MeArm/V1_PCBs/README.md

# V1_PCBs
Here we have the PCBs for the original controllers for the version 1 MeArm, including sliders and joysticks
