MeArm/V1_PCBs/MeBrain/MeBrain Spec.odt

MeBrain Specification

This is a work in progress and all comments (well most) would be appreciated.

Based on Arduino Leonardo which is an ATMega32u4 Breakout Board. Schematic and Eagle Board Files are in design folder

Must provide 6V high current power and pwm control for 4 hobby servos. Our basic servos can draw up to 1A each, the metal gear versions we plan to provide as an upgrade can draw more. It would be good to test these and work to them as a requirement. If higher current could be provided via the board it should to make the product easy to use with as many 4 servo systems as possible. I2C module is available to cover power and control and should be investigated. (Schematic and Eagle Board Files are in design folder)

Should have connectivity (whether pins or footprints for):

Wireless XBEE style module
Bluetooth LE module
LCD Screen

Controls to be placed on daughter boards. Currently we use 4 analogue outputs, would like to explore I2C as a possibility. There are two daughter boards designs, one for joystick style potentimeters and another for slider type.

Open source – Altium files to be released, also if we can convert to Eagle that would be good.

Low-cost

Surface mount – the unit will be pre-built

4 x servo 3 pin sockets

Servos controlled on D6,D9,D10,D11 (all PWM)

Servo outputs need to cope with current. The power wires need to be thick. The

control wires don’t need to change.

Analogue inputs on A0,A1,A2,A3

Programmed with external programmer (FTDI unit 6 x 1) – Supplied separately.

ISP 3 x2 programming header.

LEDs to show status. LEDs on pins D12 and D13. An additional one for playing with on another PWM pin

Connectors on I/O pins for hacking

ON/OFF switch.

Shape – to fit base plate on MeArm
