MeArm/V1_PCBs/MeBrain/PiBrains/TwoSnap/BrainsandJoy-F_Cu.dxf

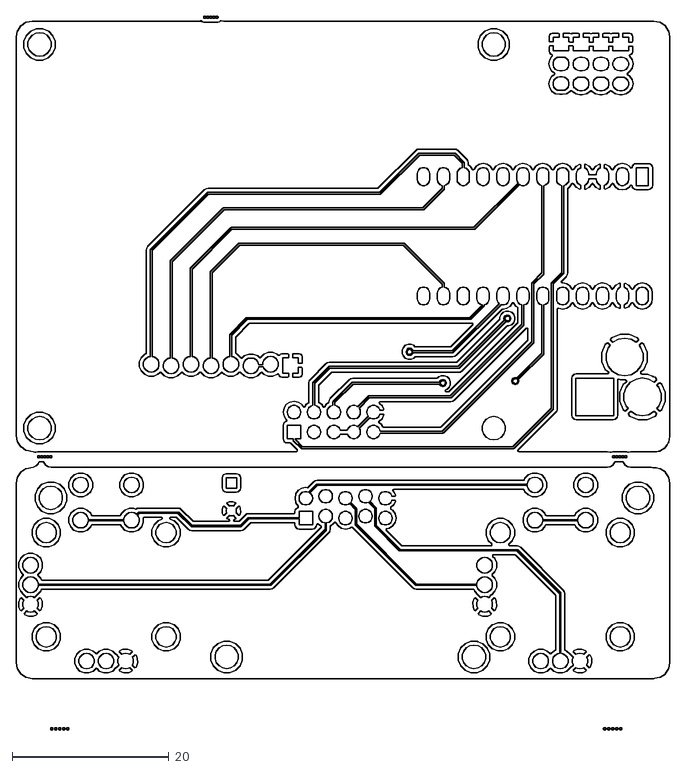
[picture p1: CAD file, 2023-10-12]
MeBrain/PiBrains/TwoSnap/BrainsandJoy-F_Cu.dxf
83.5 x 91.2
