MeArm/V1_PCBs/MeBrain/PiBrains/TwoSnap/BrainsandJoy-Edge_Cuts.dxf

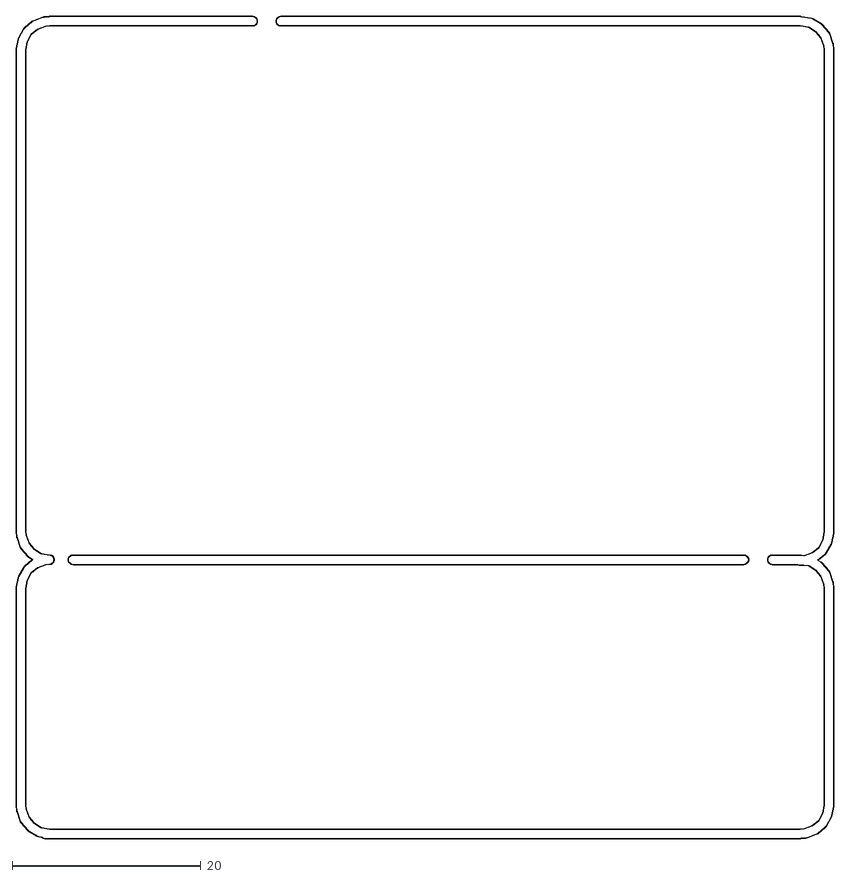
[picture p2: CAD file, 2023-10-12]
MeBrain/PiBrains/TwoSnap/BrainsandJoy-Edge_Cuts.dxf
86.5 x 87.0
