MeArm/V1_PCBs/(list of files, cad)

Other CAD files:
MeBrain/PiBrains/TwoSnap/BrainsandJoy.dxf
MeBrain/PiBrains/TwoSnap/BrainsandJoy-F_SilkS.dxf
MeBrain/PiBrains/TwoSnap/BrainsandJoy.dwg
