MeArm/V1_PCBs/slide/slide.kicad_pcb

## KiCad design slide/slide.kicad_pcb (2023-10-12)

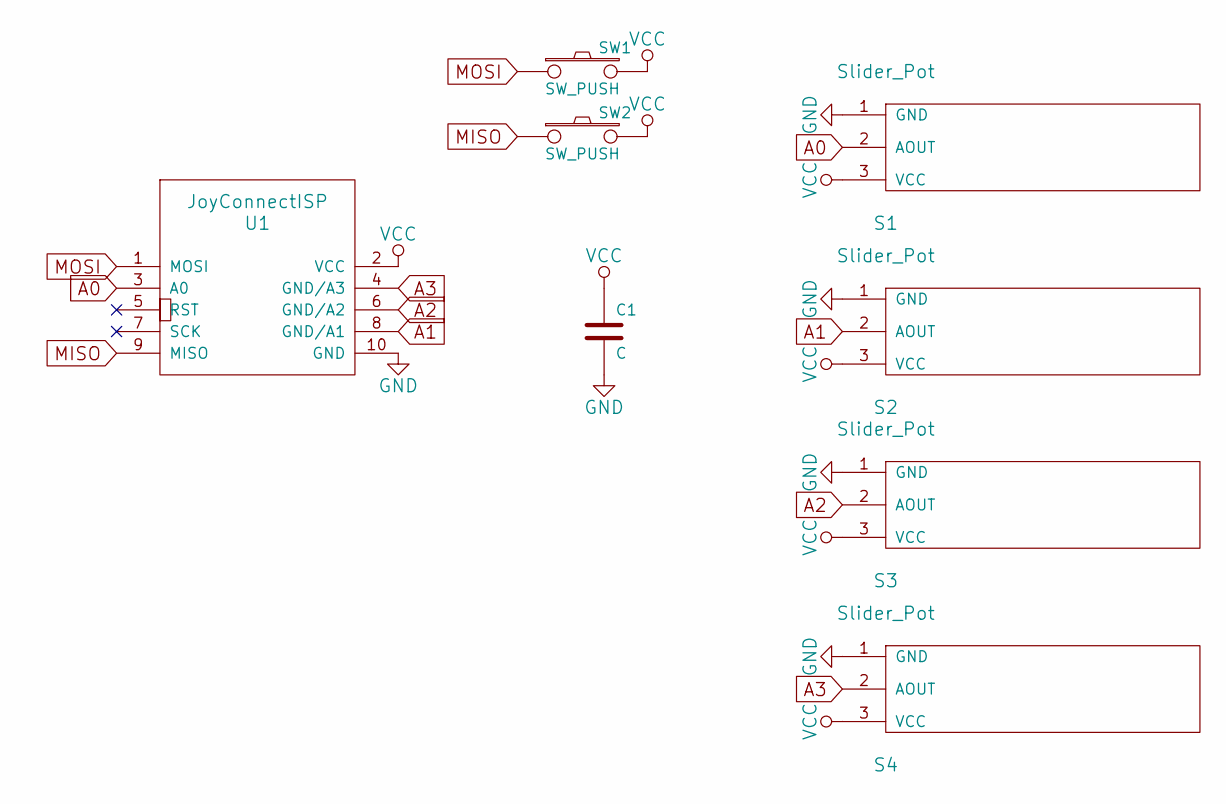
[picture p3: schematic slide.sch]

Parts:
C1: C; C_Disc_D3_P2.5
S1, S2, S3, S4: Slider_Pot; Slider_Potentiometer
SW1, SW2: SW_PUSH; TacSwitch
U1: JoyConnectISP; Pin_Header_Straight_2x05

Connections:
A0: S1.2 (AOUT), U1.3 (A0)
A1: S2.2 (AOUT), U1.8 (GND/A1)
A2: S3.2 (AOUT), U1.6 (GND/A2)
A3: S4.2 (AOUT), U1.4 (GND/A3)
GND: C1.2, S1.1 (GND), S2.1 (GND), S3.1 (GND), S4.1 (GND), U1.10 (GND)
MISO: SW2.1, U1.9 (MISO)
MOSI: SW1.1, U1.1 (MOSI)
VCC: C1.1, S1.3 (VCC), S2.3 (VCC), S3.3 (VCC), S4.3 (VCC), SW1.2, SW2.2, U1.2 (VCC)

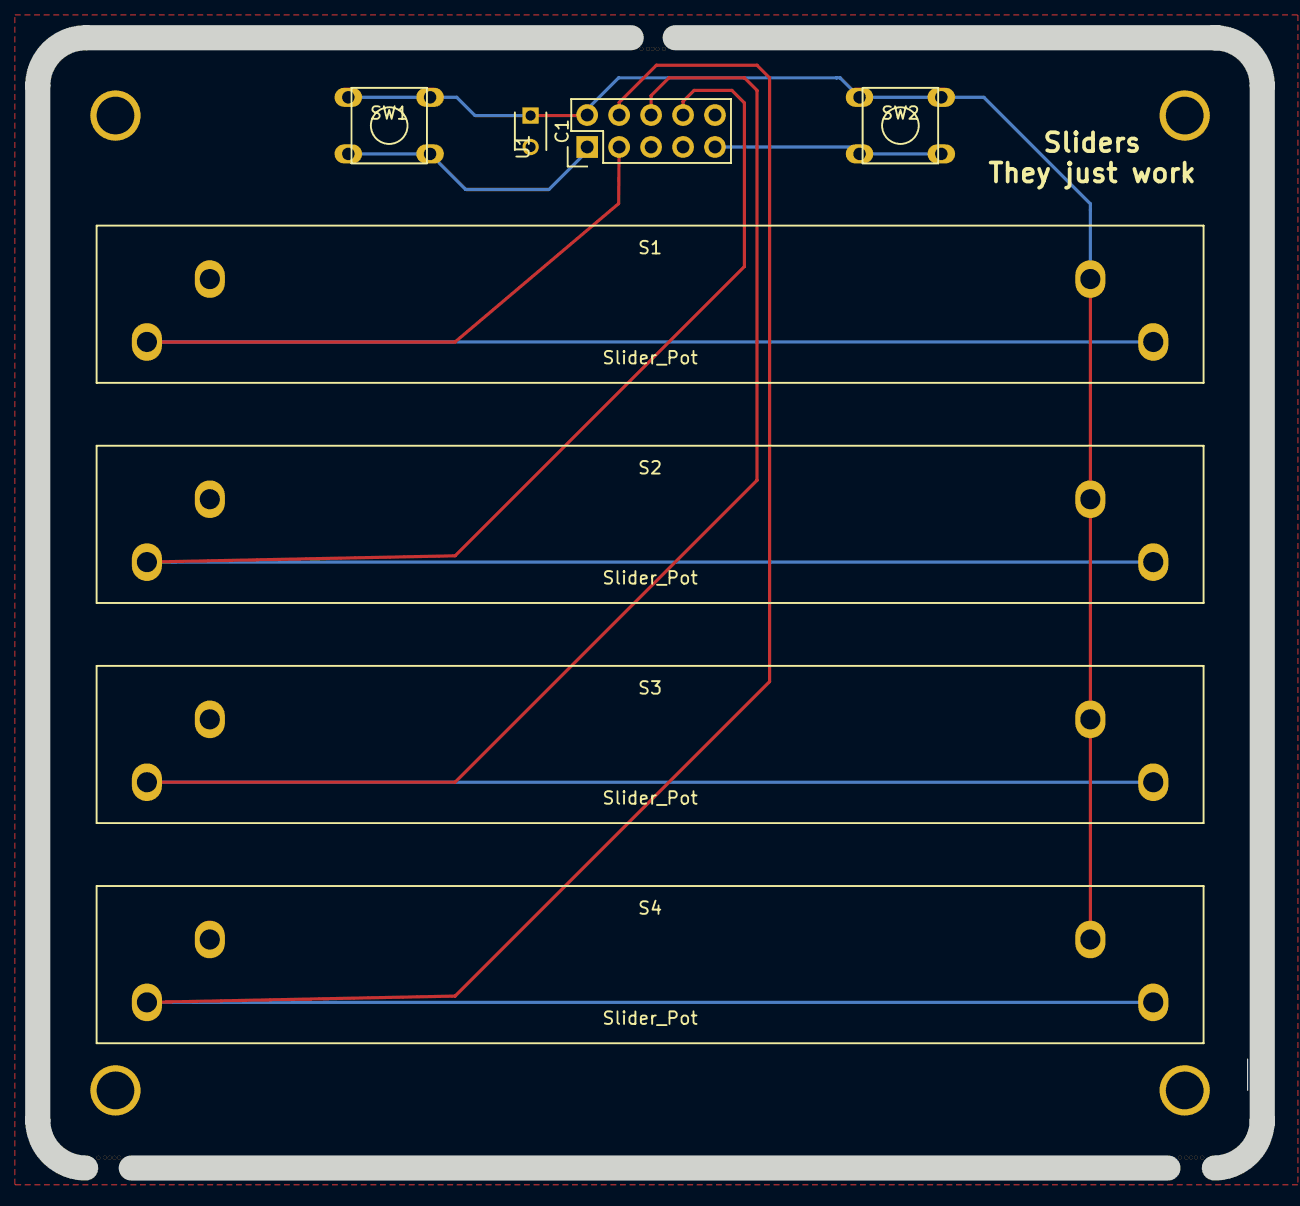
[picture p4: board slide.kicad_pcb from above]

Board: 2 copper layers, 97.3 x 89.9 mm, 8 parts (0 on the bottom side), 8 nets.
