MeArm/V1_PCBs/sticks/sticks.kicad_pcb

## KiCad design sticks/sticks.kicad_pcb (2023-10-12)

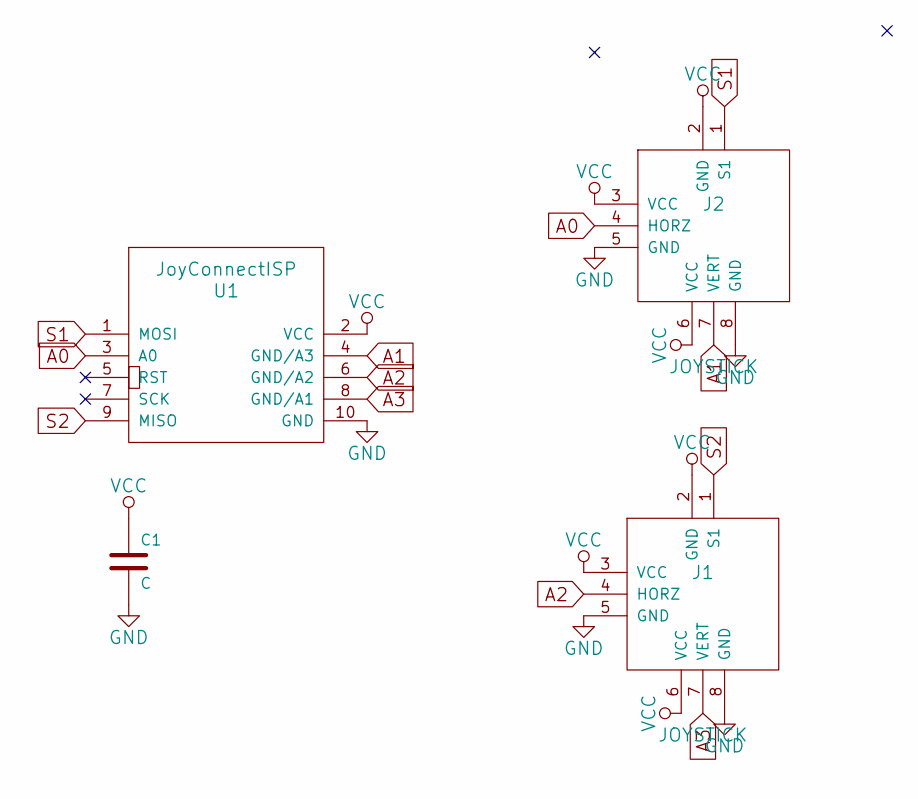
[picture p5: schematic sticks.sch]

Parts:
C1: C; C_Disc_D3_P2.5
J1, J2: JOYSTICK; JOYSTICKS
U1: JoyConnectISP; Pin_Header_Straight_2x05

Connections:
A0: J2.4 (HORZ), U1.3 (A0)
A1: J2.7 (VERT), U1.4 (GND/A3)
A2: J1.4 (HORZ), U1.6 (GND/A2)
A3: J1.7 (VERT), U1.8 (GND/A1)
GND: C1.2, J1.5 (GND), J1.8 (GND), J2.5 (GND), J2.8 (GND), U1.10 (GND)
S1: J2.1 (S1), U1.1 (MOSI)
S2: J1.1 (S1), U1.9 (MISO)
VCC: C1.1, J1.2 (GND), J1.3 (VCC), J1.6 (VCC), J2.2 (GND), J2.3 (VCC), J2.6 (VCC), U1.2 (VCC)

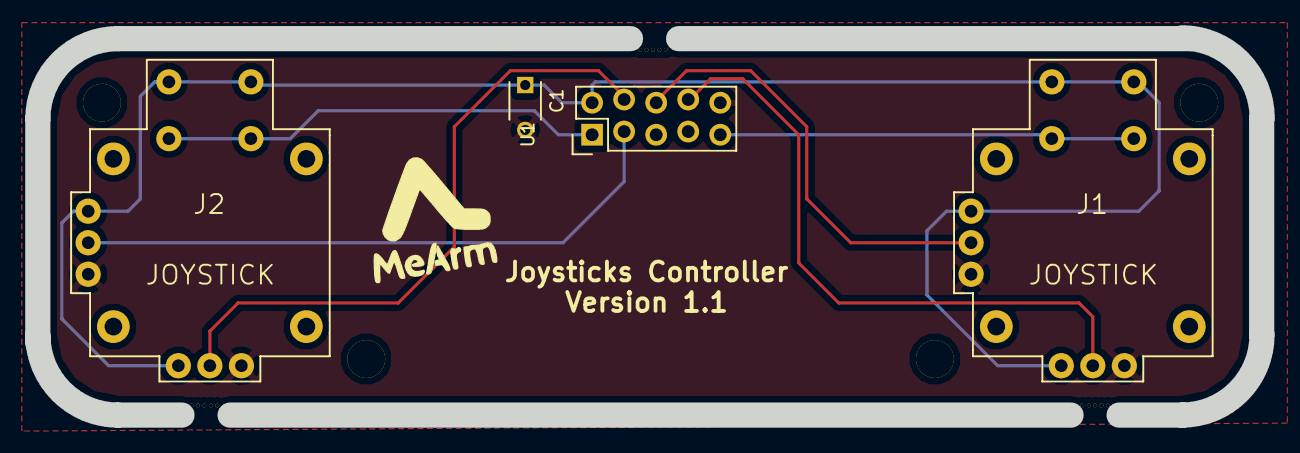
[picture p6: board sticks.kicad_pcb from above]

Board: 2 copper layers, 97.1 x 29.9 mm, 4 parts (0 on the bottom side), 8 nets.
