MeArm/V1_PCBs/MeBrain/PiBrains/brains.kicad_pcb

## KiCad design MeBrain/PiBrains/brains.kicad_pcb (2023-10-12)

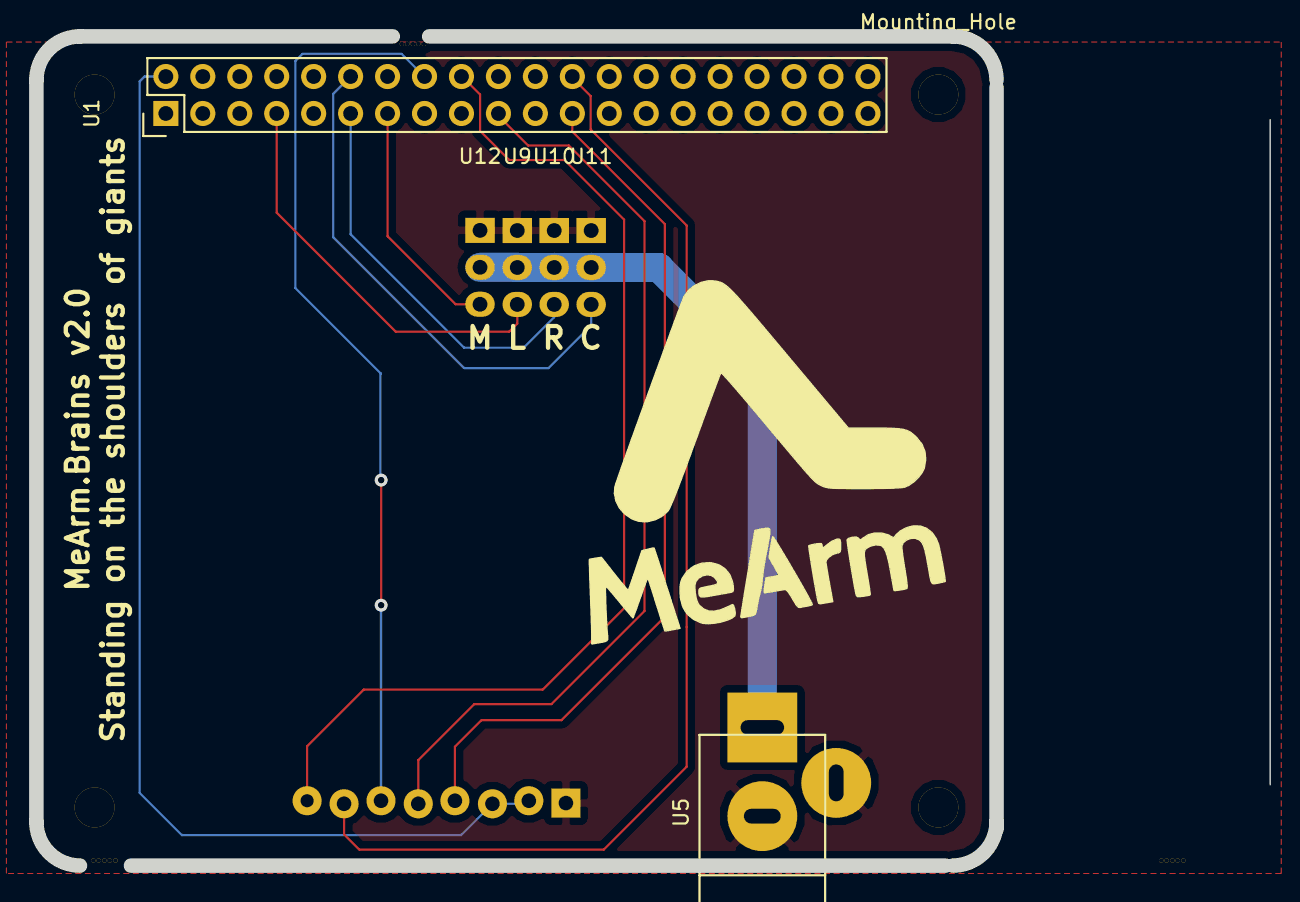
[picture p7: board MeBrain/PiBrains/brains.kicad_pcb from above]

Board: 4 copper layers, 84.8 x 57.0 mm, 7 parts (0 on the bottom side), 6 nets.

Parts:
Mounting_Hole: Mounting_Hole
U1: PIGPIO_f; Pin_Header_Straight_2x20
U5: JACK_2MM1; JACK_ALIM
U9, U10, U11, U12: Servo; Pin_Header_Straight_1x03

Connections:
+6V: U5.1, U9.2, U10.2, U11.2, U12.2
CLAW: U1.13, U12.3
GND: U1.25, U5.2, U5.3, U9.1, U10.1, U11.1, U12.1
LEFT: U1.11, U10.3
RIGHT: U1.12, U11.3
WAIST: U1.7, U9.3
