MeArm/V1_PCBs/brains/brains.kicad_pcb

## KiCad design brains/brains.kicad_pcb (2023-10-12)

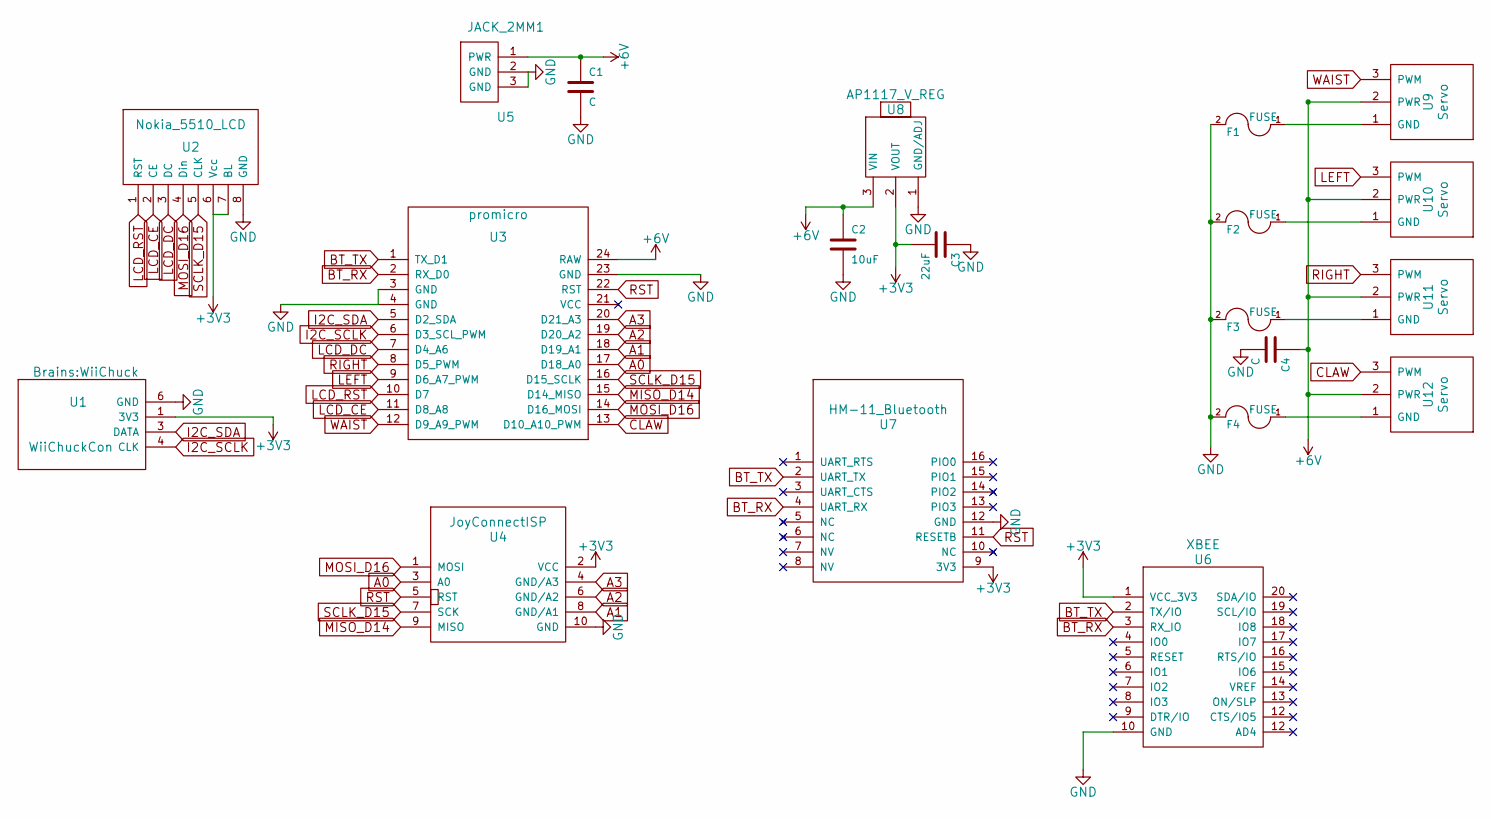
[picture p8: schematic brains.sch]

Parts:
C1: C; EEE1CA471UP_Capacitor
C2: 10uF; C_0805
C3: 22uF; C_1206
C4: C; C_0805
F1, F2, F3, F4: FUSE; Surface_Mount_1812_Polyfuse
U1: WiiChuckCon; WiiChuck
U2: Nokia_5510_LCD; Nokia5510LCD
U3: promicro; DIP-24__600_ELL
U4: JoyConnectISP; Pin_Header_Straight_2x05
U5: JACK_2MM1; JACK_ALIM
U6: XBEE
U7: HM-11_Bluetooth; HM-11_BT
U8: AP1117_V_REG; SOT-223
U9, U10, U11, U12: Servo; Pin_Header_Straight_1x03

Connections:
+3V3: C3.2, U1.1 (3V3), U2.6 (Vcc), U2.7 (BL), U4.2 (VCC), U6.1 (VCC_3V3), U7.9 (3V3), U8.2 (VOUT); also elsewhere on the board
+6V: C1.1, C2.1, C4.1, U3.24 (RAW), U5.1 (PWR), U8.3 (VIN), U9.2 (PWR), U10.2 (PWR), U11.2 (PWR), U12.2 (PWR)
A0: U3.17 (D18_A0), U4.3 (A0)
A1: U3.18 (D19_A1), U4.8 (GND/A1)
A2: U3.19 (D20_A2), U4.6 (GND/A2)
A3: U3.20 (D21_A3), U4.4 (GND/A3)
BT_RX: U3.2 (RX_D0), U6.3 (RX_IO), U7.4 (UART_RX); also elsewhere on the board
BT_TX: U3.1 (TX_D1), U6.2 (TX/IO), U7.2 (UART_TX); also elsewhere on the board
CLAW: U3.13 (D10_A10_PWM), U12.3 (PWM)
GND: C1.2, C2.2, C3.1, C4.2, F1.2, F2.2, F3.2, F4.2, U1.6 (GND), U2.8 (GND), U3.3 (GND), U3.4 (GND), U3.23 (GND), U4.10 (GND), U5.2 (GND), U5.3 (GND), U6.10 (GND), U7.12 (GND), U8.1 (GND/ADJ); also elsewhere on the board
I2C_SCLK: U1.4 (CLK), U3.6 (D3_SCL_PWM)
I2C_SDA: U1.3 (DATA), U3.5 (D2_SDA)
LCD_CE: U2.2 (CE), U3.11 (D8_A8)
LCD_DC: U2.3 (DC), U3.7 (D4_A6)
LCD_RST: U2.1 (RST), U3.10 (D7)
LEFT: U3.9 (D6_A7_PWM), U10.3 (PWM)
MISO_D14: U3.15 (D14_MISO), U4.9 (MISO)
MOSI_D16: U2.4 (Din), U3.14 (D16_MOSI), U4.1 (MOSI)
unnamed: F1.1, U9.1 (GND)
unnamed: F2.1, U10.1 (GND)
unnamed: F3.1, U11.1 (GND)
unnamed: F4.1, U12.1 (GND)
RIGHT: U3.8 (D5_PWM), U11.3 (PWM)
RST: U3.22 (RST), U4.5 (RST), U7.11 (RESETB)
SCLK_D15: U2.5 (CLK), U3.16 (D15_SCLK), U4.7 (SCK)
WAIST: U3.12 (D9_A9_PWM), U9.3 (PWM)

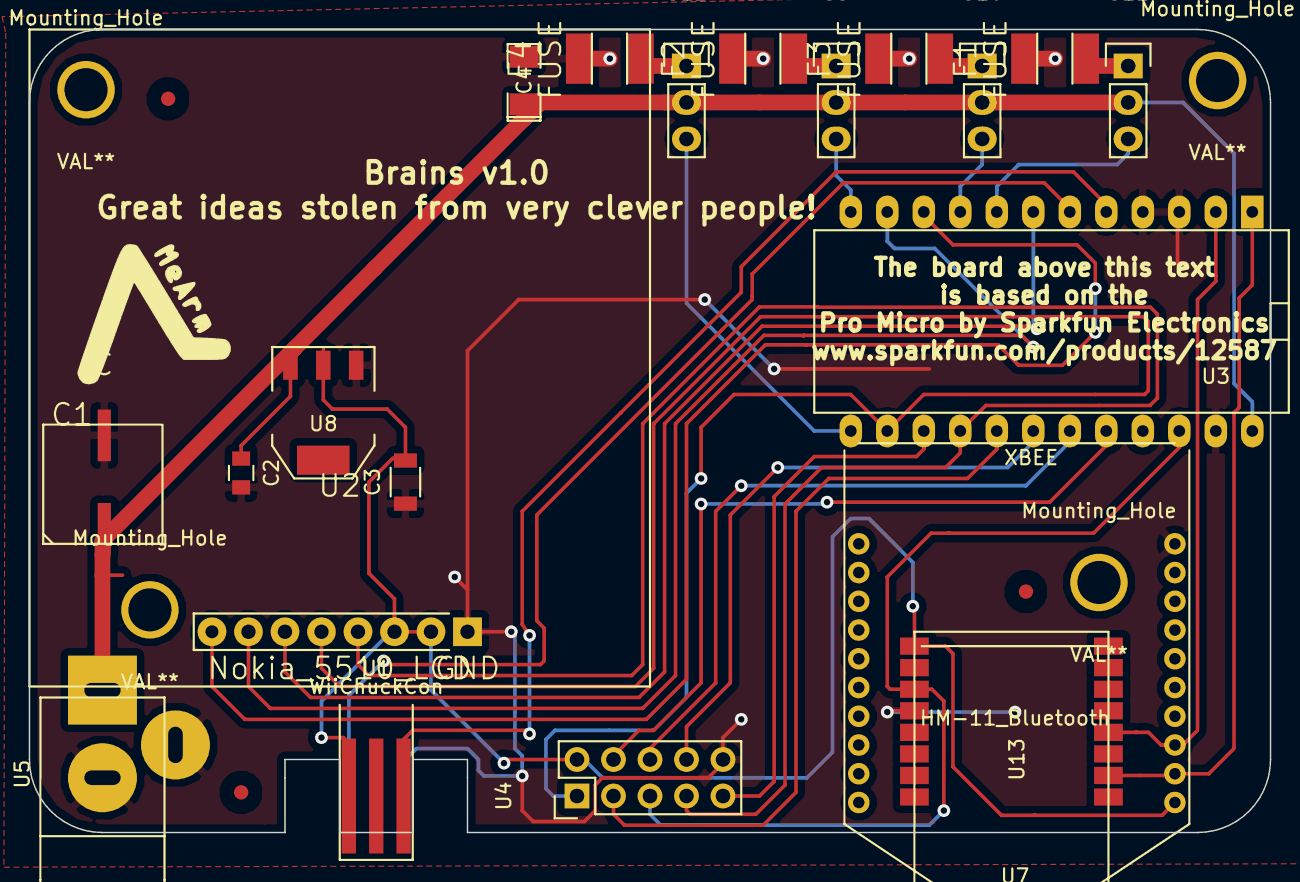
[picture p9: board brains/brains.kicad_pcb from above]

Board: 2 copper layers, 86.4 x 55.9 mm, 24 parts (0 on the bottom side), 26 nets.

Other parts of the board:
Mounting_Hole: VAL**; Mounting_Hole
Mounting_Hole#2, Mounting_Hole#3, Mounting_Hole#4: VAL**; Mounting_Hole
U13: XBEE

Their connections:
+3V3: U13.1; also elsewhere on the board
BT_RX: U13.3; also elsewhere on the board
BT_TX: U13.2; also elsewhere on the board
GND: U13.10; also elsewhere on the board
