MeArm/V1_PCBs/MeBrain/PiBrains/BrainsandJoy.kicad_pcb

## KiCad design MeBrain/PiBrains/BrainsandJoy.kicad_pcb (2023-10-12)

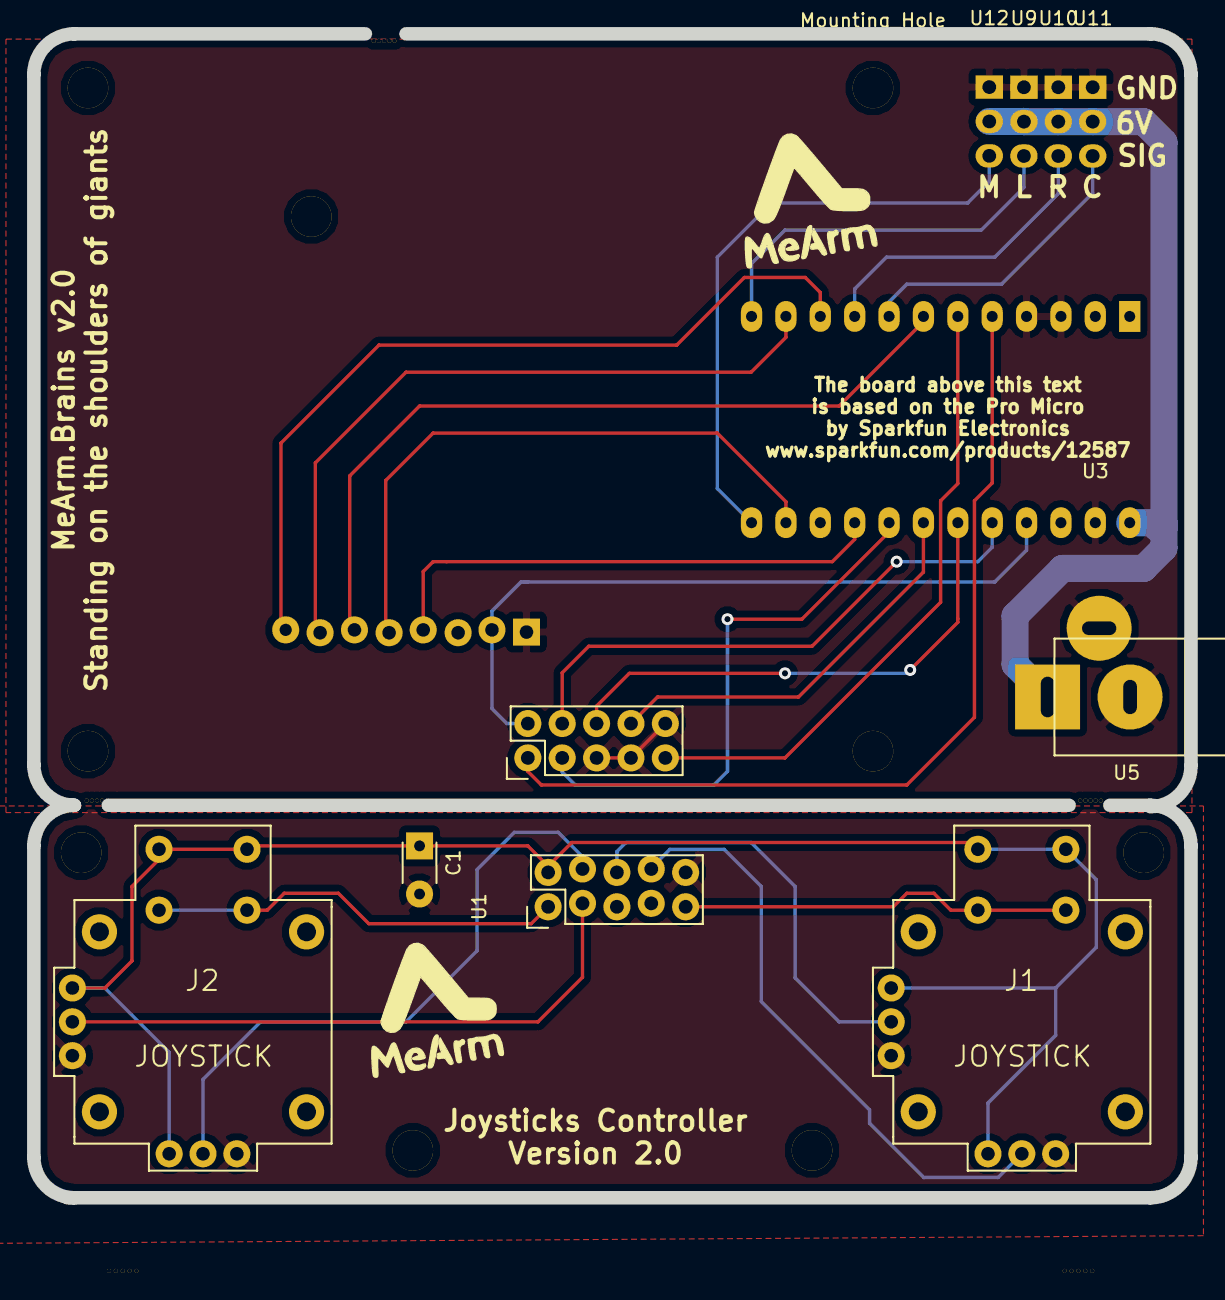
[picture p10: board BrainsandJoy.kicad_pcb from above]

Board: 4 copper layers, 85.5 x 86.0 mm, 11 parts (0 on the bottom side), 13 nets.

Parts:
C1: C; C_Disc_D3_P2.5
J1, J2: JOYSTICK; JOYSTICKS
Mounting_Hole: Mounting_Hole
U1: JoyConnectISP; Pin_Header_Straight_2x05
U3: promicro; DIP-24__600_ELL
U5: JACK_2MM1; JACK_ALIM
U9, U10, U11, U12: Servo; Pin_Header_Straight_1x03

Connections:
+6V: U3.24, U5.1, U9.2, U10.2, U11.2, U12.2
A0: J2.4, U1.3, U3.17
A1: J2.7, U1.4, U3.18
A2: J1.4, U1.6, U3.19
A3: J1.7, U1.8, U3.20
CLAW: U3.13, U12.3
GND: C1.2, J1.5, J1.8, J2.5, J2.8, U1.10, U3.3, U3.4, U3.23, U5.2, U5.3, U9.1, U10.1, U11.1, U12.1
LEFT: U3.9, U10.3
RIGHT: U3.8, U11.3
S1: J2.1, U1.1
S2: J1.1, U1.9
VCC: C1.1, J1.2, J1.3, J1.6, J2.2, J2.3, J2.6, U1.2
WAIST: U3.12, U9.3
