MeArm/V1_PCBs/(notices)

Notices in the files:
MeBrain/brains/brains.kicad_pcb:
CC-BY-SA 3.0
